contactmridulhere-commits/Multi-Vital-Device/Image/Working on original Firmware.png

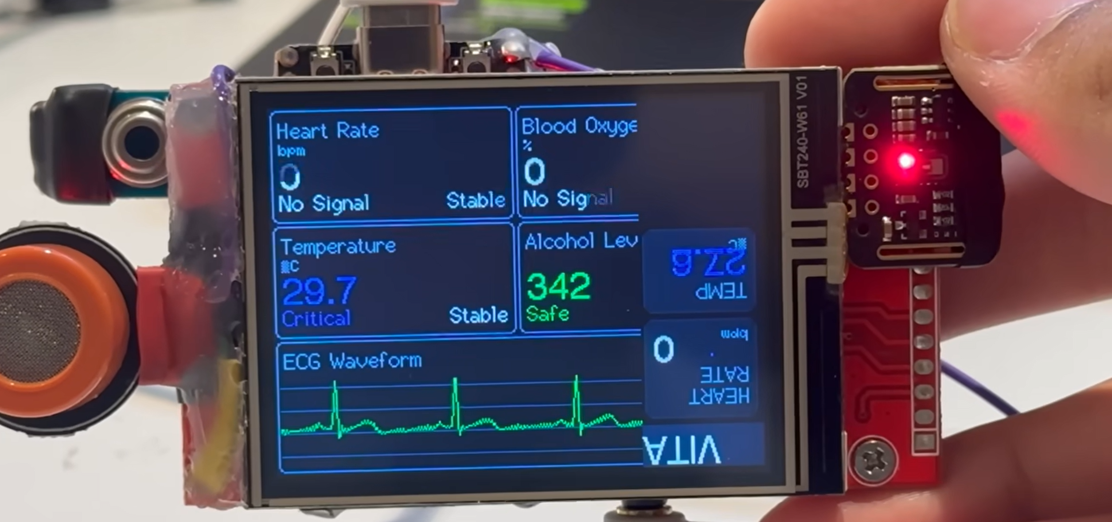
Image/Working on original Firmware.png
