contactmridulhere-commits/Multi-Vital-Device/Image/Final working.jpeg

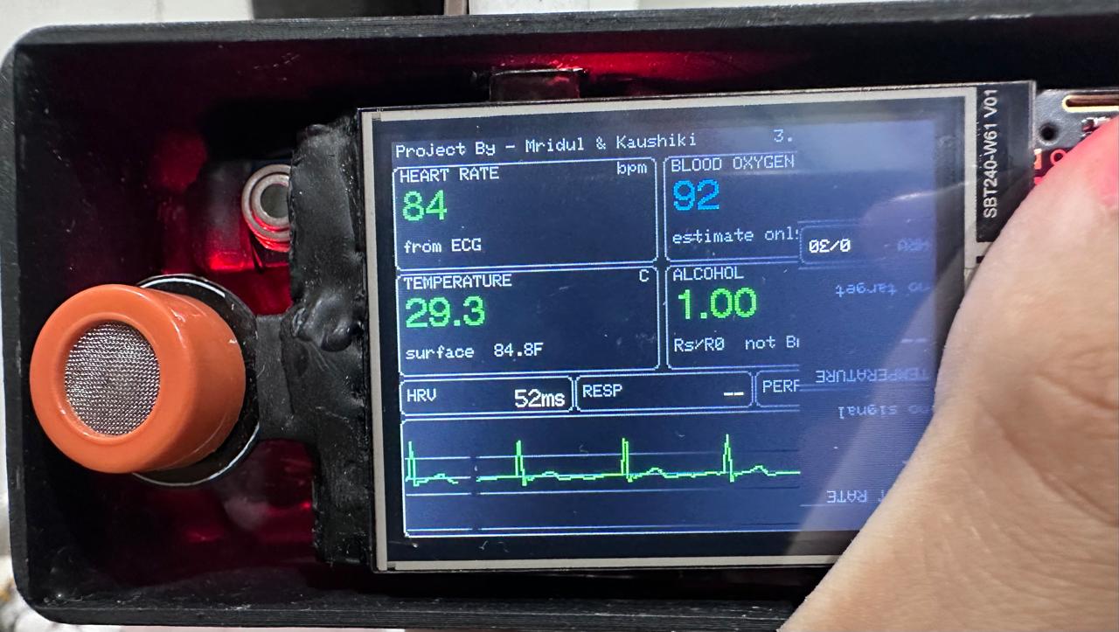
Image/Final working.jpeg
