contactmridulhere-commits/Multi-Vital-Device/Circuit.pdf

# Multi-Vital Monitor - Wiring

ESP32 (classic, dual core) - every connection in the build

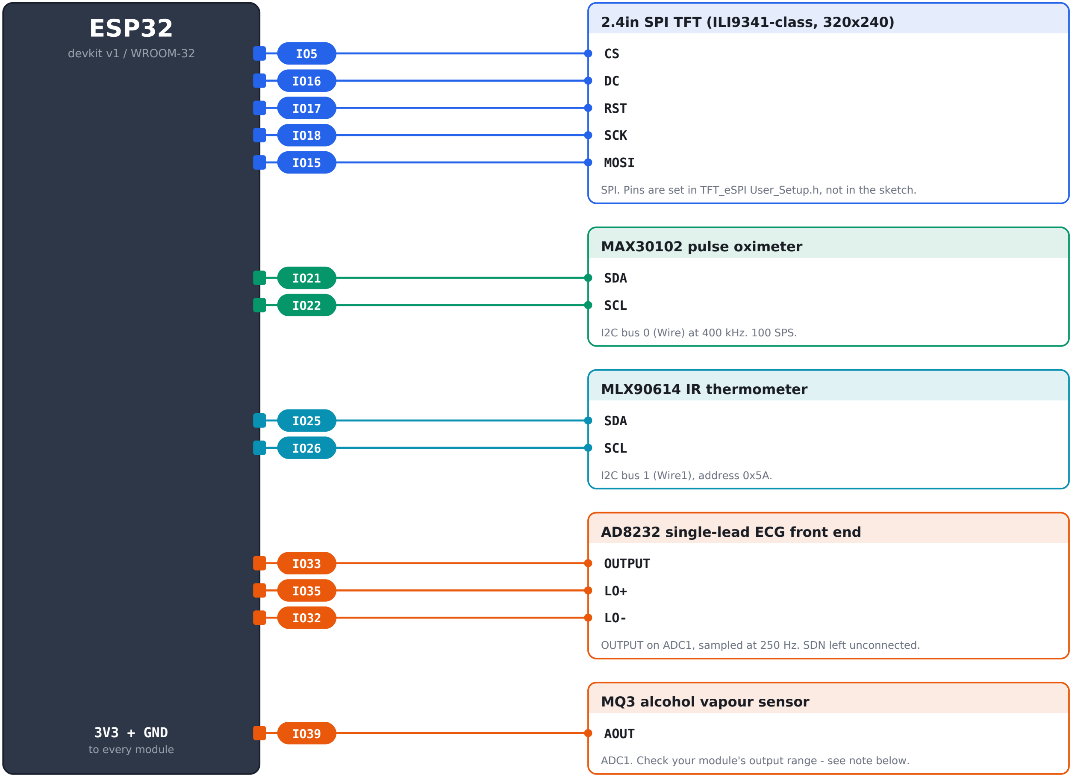
[picture p3: figure]
ESP32; devkit v1 / WROOM-32; 3V3 + GND; to every module; 2.4in SPI TFT (ILI9341-class, 320x240); RST; SCK; MOSI; MAX30102 pulse oximeter; SDA; SCL; I2C bus 0 (Wire) at 400 kHz. 100 SPS.; MLX90614 IR thermometer; I2C bus 1 (Wire1), address 0x5A.; AD8232 single-lead ECG front end; OUTPUT; MQ3 alcohol vapour sensor; AOUT

SPI. Pins are set in TFT_eSPI User_Setup.h, not in the sketch.

OUTPUT on ADC1, sampled at 250 Hz. SDN left unconnected.

ADC1. Check your module's output range - see note below.

### Before you wire it

- GPIO 34/35/36/39 are INPUT ONLY on the classic ESP32 - no output driver, no internal pull-ups.
- GPIO 15 is a strapping pin. It boots high, which is correct here. Never tie it externally low.
- Both analog inputs (33, 39) are on ADC1. ADC2 cannot be read while WiFi is active.
- MQ3 modules often run the heater from 5 V and can swing AOUT above 3.3 V - add a divider if yours does.

All modules: VCC to 3V3, GND to GND. AD8232 SDN is deliberately unconnected - the breakout holds it high.
