contactmridulhere-commits/Multi-Vital-Device/Image/2nd image of final working.jpeg

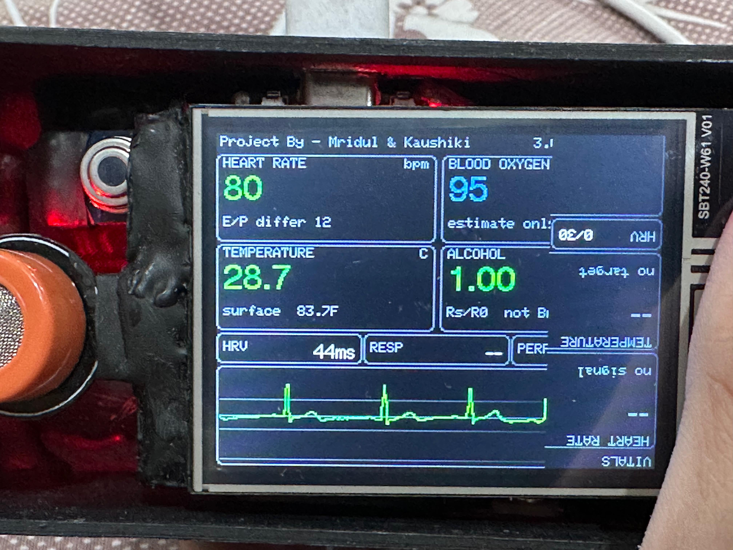
Image/2nd image of final working.jpeg
