contactmridulhere-commits/Multi-Vital-Device/Image/Overall-Look.jpeg

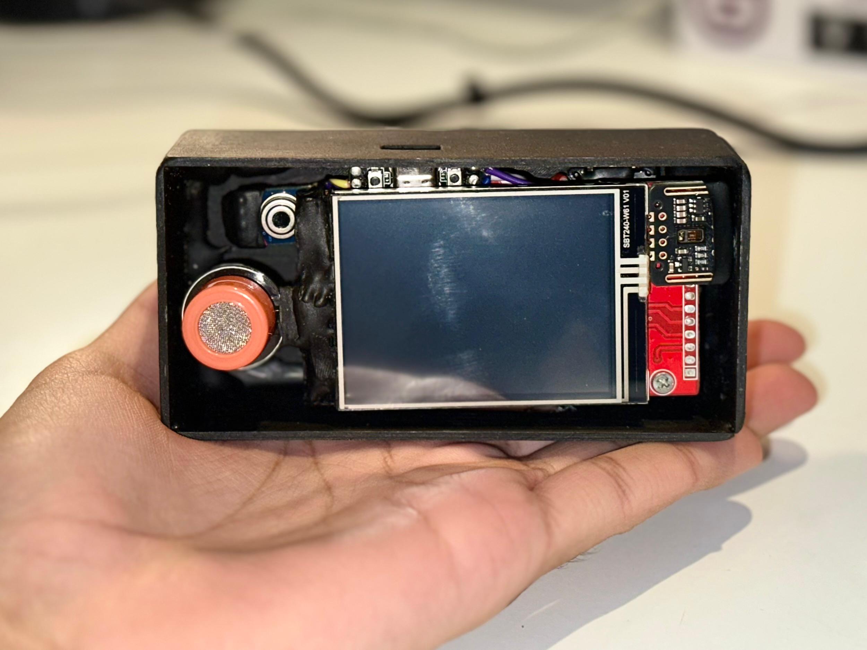
Image/Overall-Look.jpeg
