contactmridulhere-commits/Multi-Vital-Device/Pinout.png

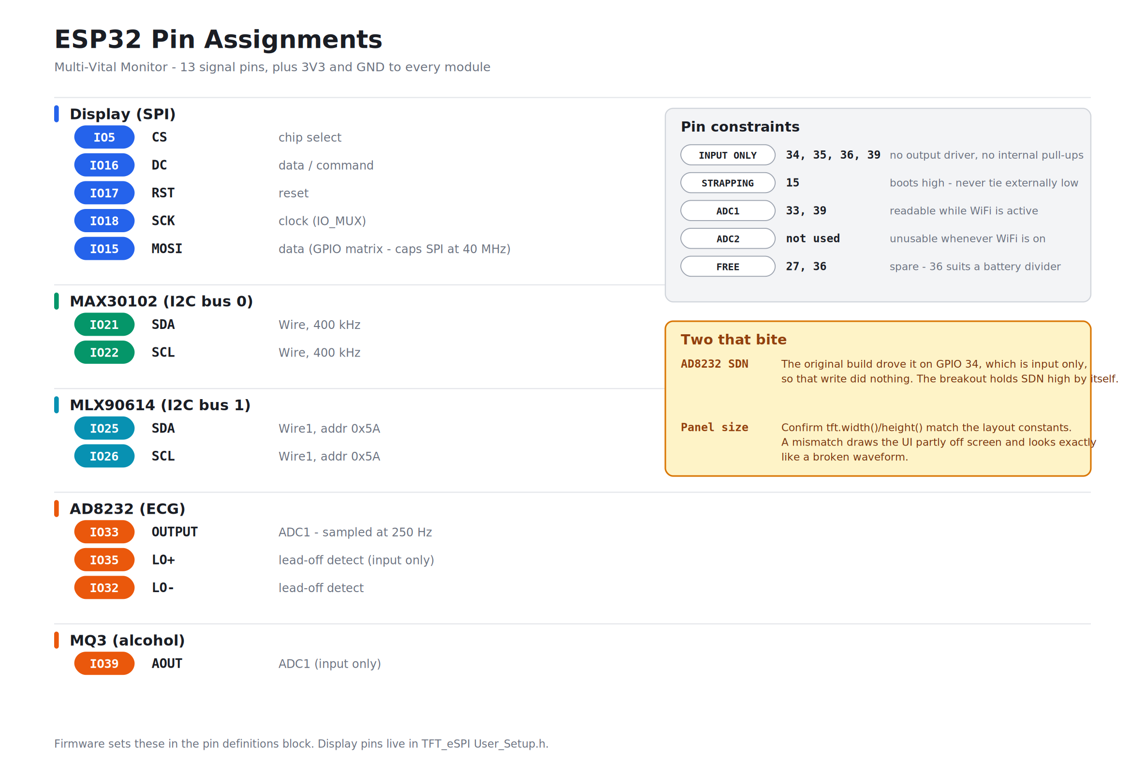
Pinout.png
