contactmridulhere-commits/Multi-Vital-Device/WiringDiagram.png

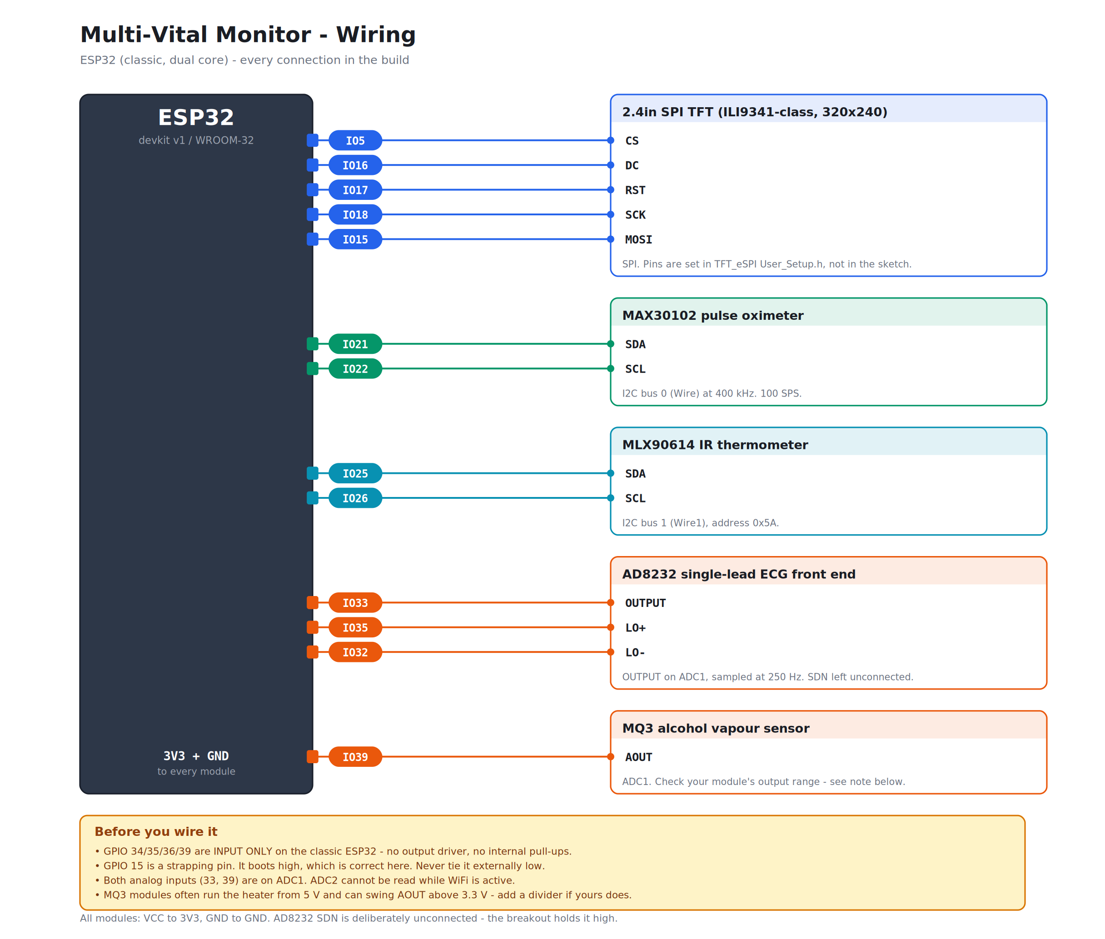
WiringDiagram.png
